arpruss/gamecube-usb-adapter/README.md

# gamecube-usb-adapter
stm32f103c-based gamecube USB HID adapter

For build instructions, see https://www.instructables.com/id/Gamecube-Controller-USB-Adapter-and-Getting-Starte/

Note: Nunchuck support is untested.
