arpruss/gamecube-usb-adapter/modelist.pdf

# Mappings with exercise machine support

0001: joystick (unified slider) 0010: joystick (2 sliders), 0.64x rot 0011: Jetset Radio joystick
0100: WASD
0101: Arrows + Ctrl/Space
0110: Arrows + Space/Back 0111: QBert (A=1, B=2) 1000: Dance pad Minecraft
1001: joystick, 1.5x rot 1010: joystick, 2x rot
1011: joystick, dir. switch slider 1100: Arrows + Z/X
1101: XBox 360
1110: Dual joystick

# Mappings without exercise machine support

### 0001: joystick (unified slider) 0010: joystick (two sliders) 0011: Jetset Radio joystick 0100: WASD 0101: Arrows + Ctrl/Space 0110: Arrows + Space/Back 0111: QBert (A=1, B=2) 1000: Dance pad Minecraft 1001: Arrows + Z/X 1010: XBox 360 1011: Dual joystick
