arpruss/gamecube-usb-adapter/gamecube-nunchuck-exercise.png

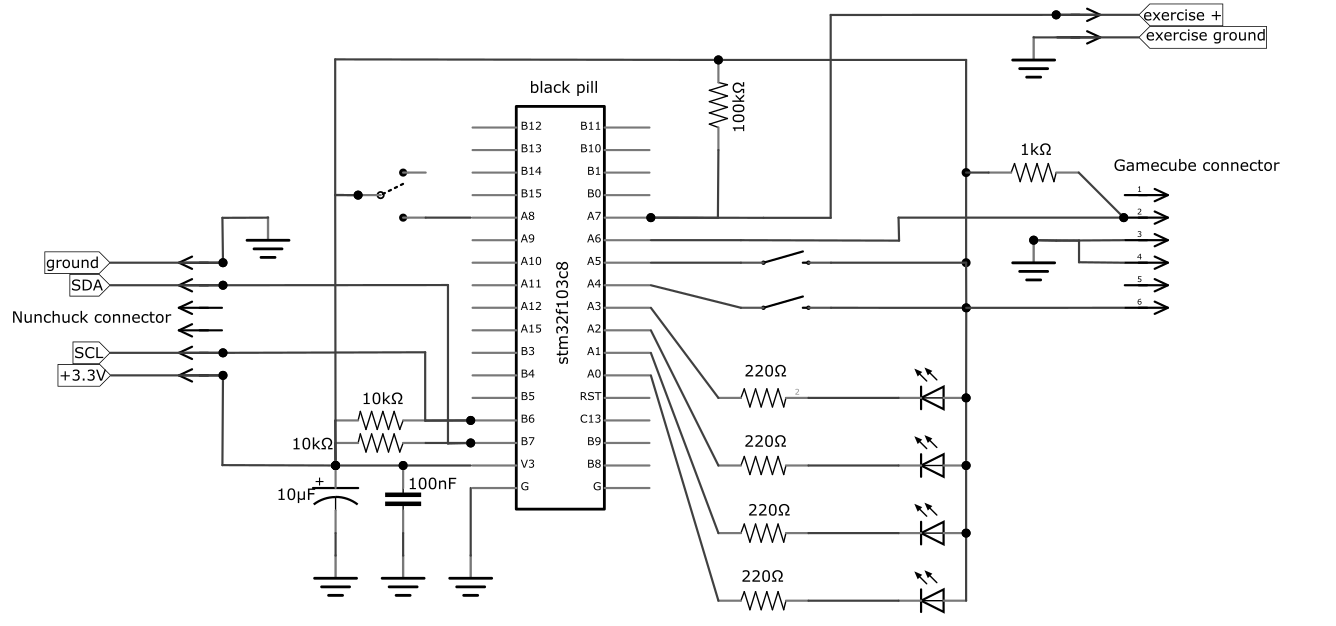
gamecube-nunchuck-exercise.png
