arpruss/gamecube-usb-adapter/gamecubecontroller_schem.png

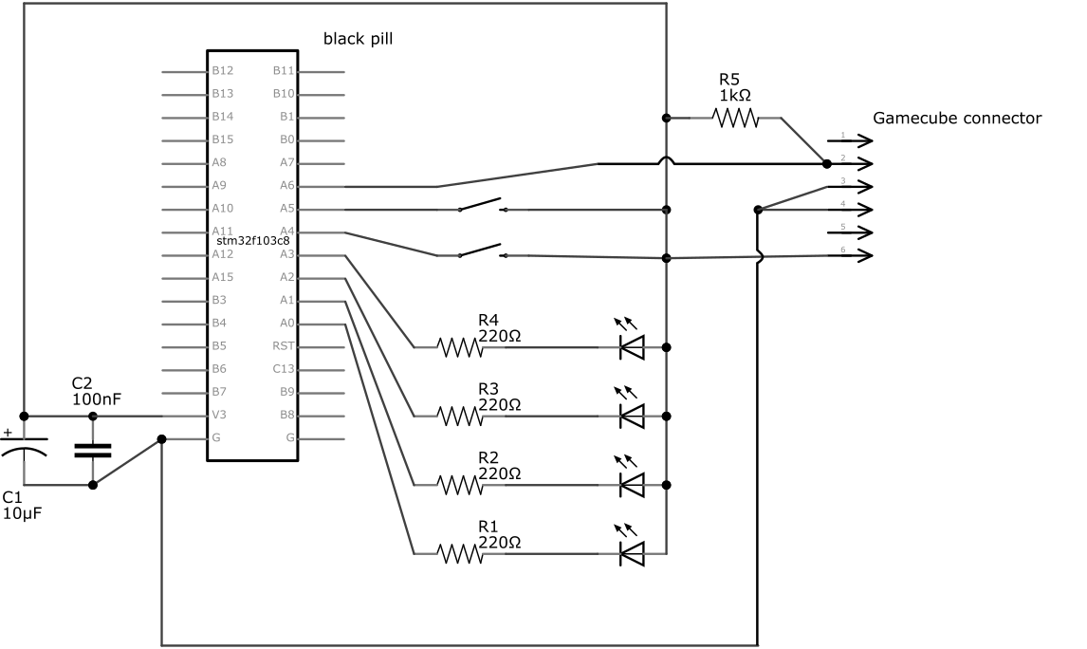
gamecubecontroller_schem.png
