arpruss/gamecube-usb-adapter/printable/gamecube-nunchuck-exercise-feet.stl

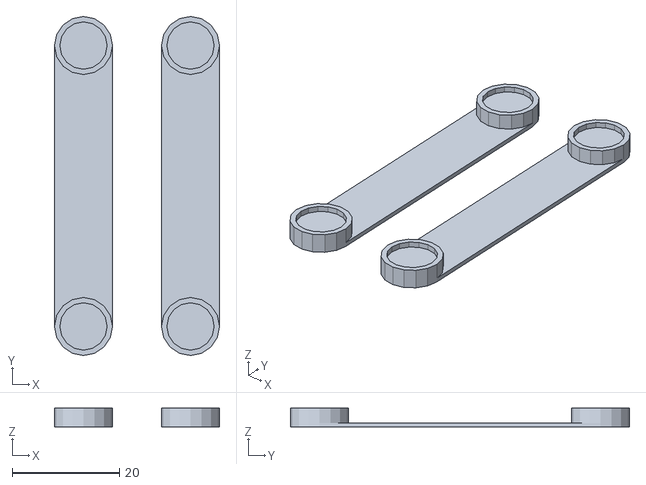
[picture p3: CAD file, 2018-01-15]
printable/gamecube-nunchuck-exercise-feet.stl
30.8 x 63.3 x 3.50
