arpruss/gamecube-usb-adapter/printable/adaptercase.stl

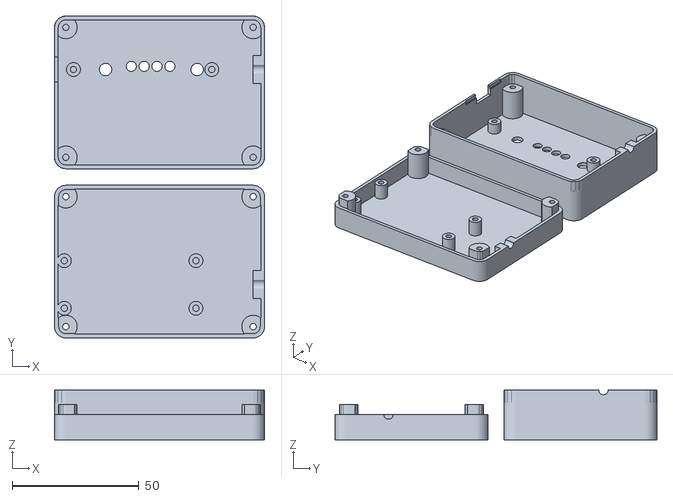
[picture p4: CAD file, 2018-01-14]
printable/adaptercase.stl
83.0 x 127.2 x 19.7
