arpruss/gamecube-usb-adapter/printable/gamecube-nunchuck-exercise-top.stl

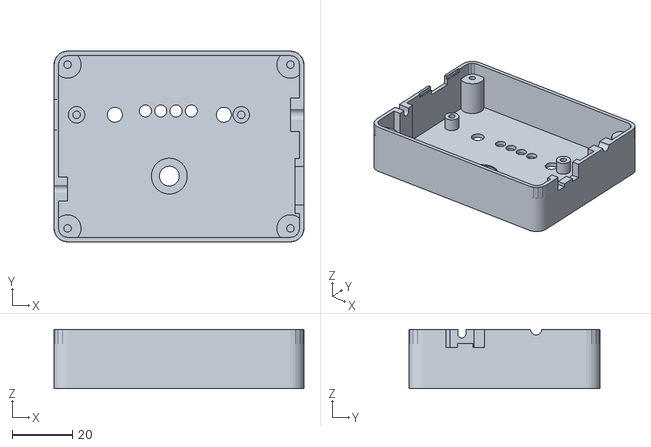
[picture p5: CAD file, 2018-01-14]
printable/gamecube-nunchuck-exercise-top.stl
83.0 x 63.3 x 19.7
