arpruss/gamecube-usb-adapter/printable/gamecube-nunchuck-exercise-bottom.stl

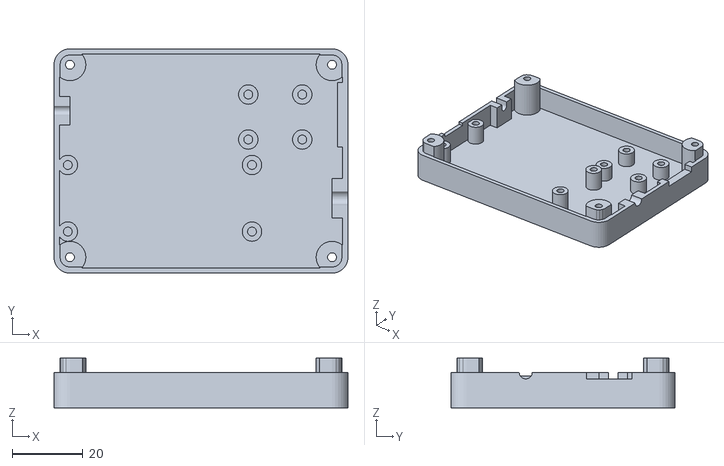
[picture p6: CAD file, 2018-01-14]
printable/gamecube-nunchuck-exercise-bottom.stl
83.0 x 63.4 x 14.0
