arpruss/gamecube-usb-adapter/(list of files, cad)

Other CAD files:
printable/roundedsquare.scad
