arpruss/gamecube-usb-adapter/(threads)

Thread 1 (2020-04-17):

XBOX 360 Controller issue

Croccy22, 2020-04-17:
Hi,

I have built this and it is all working in standard joystick mode, but whenI switch to XBOX 360 mode, it does it, the computer shows XBOX 360 controller, but then after a few seconds you here USB disconnect/reconnect and it resets back to normal joysitck mode.

Any ideas?

Thanks, MAtt.

arpruss, 2020-04-17:
What computer are you using?
And which version of the USB library are you using?

Croccy22, 2020-04-17:
I have tried it on my main PC and on my laptop, both with same result.
Computer can see it as XBOX 360 emulated device, but then resets back to
standard.

I am using the USBHID Library from here:
https://github.com/arpruss/USBComposite_stm32f1 I followed the guide from
here: Exercise Machine USB Game Controller : 8 Steps (with Pictures) -
Instructables
<https://www.instructables.com/id/Exercise-Machine-USB-Game-Controller/> but
the libraries didn't appear in the list as per the guide, so went direct to
github to download them.

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

arpruss, 2020-04-17:
Does the stm board reboot? You can tell by its doing the flashing lights startup sequence.
I've had this problem before...

arpruss, 2020-04-17:
Also, are you using the release versions or the current repository head?

Croccy22, 2020-04-17:
Yes I would definately say it is rebooting. I have been using the ones from the repository head. Shall I try the latest release libraires instead?

When I compiled I got the following messages:

In file included from C:\Users\matth\Documents\Arduino\libraries\USBComposite_stm32f1-master/usb_generic.h:11:0,

                 from C:\Users\matth\Documents\Arduino\libraries\USBComposite_stm32f1-master/USBComposite.h:6,

                 from sketch\gamecubecontroller.h:8,

                 from C:\Users\matth\Desktop\gamecubecontroller\gamecubecontroller.ino:51:

C:\Program Files (x86)\Arduino\hardware\Arduino_STM32\STM32F1\system/libmaple/usb/stm32f1/usb_reg_map.h: In function 'uint32* usb_pma_ptr(uint32)':

C:\Program Files (x86)\Arduino\hardware\Arduino_STM32\STM32F1\system/libmaple/usb/stm32f1/usb_reg_map.h:353:35: warning: pointer of type 'void *' used in arithmetic [-Wpointer-arith]

     return (uint32*)(USB_PMA_BASE + 2 * offset);

                                   ^

In file included from C:\Users\matth\Documents\Arduino\libraries\USBComposite_stm32f1-master\usb_generic.h:11:0,

                 from C:\Users\matth\Documents\Arduino\libraries\USBComposite_stm32f1-master\USBComposite.h:6,

                 from C:\Users\matth\Documents\Arduino\libraries\USBComposite_stm32f1-master\AbsMouse.cpp:1:

C:\Program Files (x86)\Arduino\hardware\Arduino_STM32\STM32F1\system/libmaple/usb/stm32f1/usb_reg_map.h: In function 'uint32* usb_pma_ptr(uint32)':

C:\Program Files (x86)\Arduino\hardware\Arduino_STM32\STM32F1\system/libmaple/usb/stm32f1/usb_reg_map.h:353:35: warning: pointer of type 'void *' used in arithmetic [-Wpointer-arith]

     return (uint32*)(USB_PMA_BASE + 2 * offset);

                                   ^

In file included from C:\Users\matth\Documents\Arduino\libraries\USBComposite_stm32f1-master\usb_generic.h:11:0,

                 from C:\Users\matth\Documents\Arduino\libraries\USBComposite_stm32f1-master\USBComposite.h:6,

                 from C:\Users\matth\Documents\Arduino\libraries\USBComposite_stm32f1-master\Consumer.cpp:1:

C:\Program Files (x86)\Arduino\hardware\Arduino_STM32\STM32F1\system/libmaple/usb/stm32f1/usb_reg_map.h: In function 'uint32* usb_pma_ptr(uint32)':

C:\Program Files (x86)\Arduino\hardware\Arduino_STM32\STM32F1\system/libmaple/usb/stm32f1/usb_reg_map.h:353:35: warning: pointer of type 'void *' used in arithmetic [-Wpointer-arith]

     return (uint32*)(USB_PMA_BASE + 2 * offset);

                                   ^

In file included from C:\Users\matth\Documents\Arduino\libraries\USBComposite_stm32f1-master\usb_generic.h:11:0,

                 from C:\Users\matth\Documents\Arduino\libraries\USBComposite_stm32f1-master\USBComposite.h:6,

                 from C:\Users\matth\Documents\Arduino\libraries\USBComposite_stm32f1-master\HIDReports.cpp:1:

C:\Program Files (x86)\Arduino\hardware\Arduino_STM32\STM32F1\system/libmaple/usb/stm32f1/usb_reg_map.h: In function 'uint32* usb_pma_ptr(uint32)':

C:\Program Files (x86)\Arduino\hardware\Arduino_STM32\STM32F1\system/libmaple/usb/stm32f1/usb_reg_map.h:353:35: warning: pointer of type 'void *' used in arithmetic [-Wpointer-arith]

     return (uint32*)(USB_PMA_BASE + 2 * offset);

                                   ^

In file included from C:\Users\matth\Documents\Arduino\libraries\USBComposite_stm32f1-master\usb_generic.h:11:0,

                 from C:\Users\matth\Documents\Arduino\libraries\USBComposite_stm32f1-master\USBComposite.h:6,

                 from C:\Users\matth\Documents\Arduino\libraries\USBComposite_stm32f1-master\Joystick.cpp:1:

C:\Program Files (x86)\Arduino\hardware\Arduino_STM32\STM32F1\system/libmaple/usb/stm32f1/usb_reg_map.h: In function 'uint32* usb_pma_ptr(uint32)':

C:\Program Files (x86)\Arduino\hardware\Arduino_STM32\STM32F1\system/libmaple/usb/stm32f1/usb_reg_map.h:353:35: warning: pointer of type 'void *' used in arithmetic [-Wpointer-arith]

     return (uint32*)(USB_PMA_BASE + 2 * offset);

                                   ^

In file included from C:\Users\matth\Documents\Arduino\libraries\USBComposite_stm32f1-master\usb_generic.h:11:0,

                 from C:\Users\matth\Documents\Arduino\libraries\USBComposite_stm32f1-master\USBComposite.h:6,

                 from C:\Users\matth\Documents\Arduino\libraries\USBComposite_stm32f1-master\Keyboard.cpp:1:

C:\Program Files (x86)\Arduino\hardware\Arduino_STM32\STM32F1\system/libmaple/usb/stm32f1/usb_reg_map.h: In function 'uint32* usb_pma_ptr(uint32)':

C:\Program Files (x86)\Arduino\hardware\Arduino_STM32\STM32F1\system/libmaple/usb/stm32f1/usb_reg_map.h:353:35: warning: pointer of type 'void *' used in arithmetic [-Wpointer-arith]

     return (uint32*)(USB_PMA_BASE + 2 * offset);

                                   ^

In file included from C:\Users\matth\Documents\Arduino\libraries\USBComposite_stm32f1-master\usb_generic.h:11:0,

                 from C:\Users\matth\Documents\Arduino\libraries\USBComposite_stm32f1-master\USBComposite.h:6,

                 from C:\Users\matth\Documents\Arduino\libraries\USBComposite_stm32f1-master\Mouse.cpp:1:

C:\Program Files (x86)\Arduino\hardware\Arduino_STM32\STM32F1\system/libmaple/usb/stm32f1/usb_reg_map.h: In function 'uint32* usb_pma_ptr(uint32)':

C:\Program Files (x86)\Arduino\hardware\Arduino_STM32\STM32F1\system/libmaple/usb/stm32f1/usb_reg_map.h:353:35: warning: pointer of type 'void *' used in arithmetic [-Wpointer-arith]

     return (uint32*)(USB_PMA_BASE + 2 * offset);

                                   ^

In file included from C:\Users\matth\Documents\Arduino\libraries\USBComposite_stm32f1-master\usb_generic.h:11:0,

                 from C:\Users\matth\Documents\Arduino\libraries\USBComposite_stm32f1-master\USBComposite.h:6,

                 from C:\Users\matth\Documents\Arduino\libraries\USBComposite_stm32f1-master\USBAudio.cpp:17:

C:\Program Files (x86)\Arduino\hardware\Arduino_STM32\STM32F1\system/libmaple/usb/stm32f1/usb_reg_map.h: In function 'uint32* usb_pma_ptr(uint32)':

C:\Program Files (x86)\Arduino\hardware\Arduino_STM32\STM32F1\system/libmaple/usb/stm32f1/usb_reg_map.h:353:35: warning: pointer of type 'void *' used in arithmetic [-Wpointer-arith]

     return (uint32*)(USB_PMA_BASE + 2 * offset);

                                   ^

In file included from C:\Users\matth\Documents\Arduino\libraries\USBComposite_stm32f1-master\usb_generic.h:11:0,

                 from C:\Users\matth\Documents\Arduino\libraries\USBComposite_stm32f1-master\USBComposite.h:6,

                 from C:\Users\matth\Documents\Arduino\libraries\USBComposite_stm32f1-master\USBComposite.cpp:1:

C:\Program Files (x86)\Arduino\hardware\Arduino_STM32\STM32F1\system/libmaple/usb/stm32f1/usb_reg_map.h: In function 'uint32* usb_pma_ptr(uint32)':

C:\Program Files (x86)\Arduino\hardware\Arduino_STM32\STM32F1\system/libmaple/usb/stm32f1/usb_reg_map.h:353:35: warning: pointer of type 'void *' used in arithmetic [-Wpointer-arith]

     return (uint32*)(USB_PMA_BASE + 2 * offset);

                                   ^

In file included from C:\Users\matth\Documents\Arduino\libraries\USBComposite_stm32f1-master\usb_generic.h:11:0,

                 from C:\Users\matth\Documents\Arduino\libraries\USBComposite_stm32f1-master\USBComposite.h:6,

                 from C:\Users\matth\Documents\Arduino\libraries\USBComposite_stm32f1-master\USBCompositeSerial.cpp:17:

C:\Program Files (x86)\Arduino\hardware\Arduino_STM32\STM32F1\system/libmaple/usb/stm32f1/usb_reg_map.h: In function 'uint32* usb_pma_ptr(uint32)':

C:\Program Files (x86)\Arduino\hardware\Arduino_STM32\STM32F1\system/libmaple/usb/stm32f1/usb_reg_map.h:353:35: warning: pointer of type 'void *' used in arithmetic [-Wpointer-arith]

     return (uint32*)(USB_PMA_BASE + 2 * offset);

                                   ^

In file included from C:\Users\matth\Documents\Arduino\libraries\USBComposite_stm32f1-master\usb_generic.h:11:0,

                 from C:\Users\matth\Documents\Arduino\libraries\USBComposite_stm32f1-master\USBComposite.h:6,

                 from C:\Users\matth\Documents\Arduino\libraries\USBComposite_stm32f1-master\USBHID.cpp:18:

C:\Program Files (x86)\Arduino\hardware\Arduino_STM32\STM32F1\system/libmaple/usb/stm32f1/usb_reg_map.h: In function 'uint32* usb_pma_ptr(uint32)':

C:\Program Files (x86)\Arduino\hardware\Arduino_STM32\STM32F1\system/libmaple/usb/stm32f1/usb_reg_map.h:353:35: warning: pointer of type 'void *' used in arithmetic [-Wpointer-arith]

     return (uint32*)(USB_PMA_BASE + 2 * offset);

                                   ^

In file included from C:\Users\matth\Documents\Arduino\libraries\USBComposite_stm32f1-master\usb_generic.h:11:0,

                 from C:\Users\matth\Documents\Arduino\libraries\USBComposite_stm32f1-master\USBComposite.h:6,

                 from C:\Users\matth\Documents\Arduino\libraries\USBComposite_stm32f1-master\USBMIDI.cpp:41:

C:\Program Files (x86)\Arduino\hardware\Arduino_STM32\STM32F1\system/libmaple/usb/stm32f1/usb_reg_map.h: In function 'uint32* usb_pma_ptr(uint32)':

C:\Program Files (x86)\Arduino\hardware\Arduino_STM32\STM32F1\system/libmaple/usb/stm32f1/usb_reg_map.h:353:35: warning: pointer of type 'void *' used in arithmetic [-Wpointer-arith]

     return (uint32*)(USB_PMA_BASE + 2 * offset);

                                   ^

In file included from C:\Users\matth\Documents\Arduino\libraries\USBComposite_stm32f1-master\usb_generic.h:11:0,

                 from C:\Users\matth\Documents\Arduino\libraries\USBComposite_stm32f1-master\USBComposite.h:6,

                 from C:\Users\matth\Documents\Arduino\libraries\USBComposite_stm32f1-master\USBMassStorage.cpp:1:

C:\Program Files (x86)\Arduino\hardware\Arduino_STM32\STM32F1\system/libmaple/usb/stm32f1/usb_reg_map.h: In function 'uint32* usb_pma_ptr(uint32)':

C:\Program Files (x86)\Arduino\hardware\Arduino_STM32\STM32F1\system/libmaple/usb/stm32f1/usb_reg_map.h:353:35: warning: pointer of type 'void *' used in arithmetic [-Wpointer-arith]

     return (uint32*)(USB_PMA_BASE + 2 * offset);

                                   ^

In file included from C:\Users\matth\Documents\Arduino\libraries\USBComposite_stm32f1-master\usb_generic.h:11:0,

                 from C:\Users\matth\Documents\Arduino\libraries\USBComposite_stm32f1-master\USBComposite.h:6,

                 from C:\Users\matth\Documents\Arduino\libraries\USBComposite_stm32f1-master\USBMultiSerial.cpp:17:

C:\Program Files (x86)\Arduino\hardware\Arduino_STM32\STM32F1\system/libmaple/usb/stm32f1/usb_reg_map.h: In function 'uint32* usb_pma_ptr(uint32)':

C:\Program Files (x86)\Arduino\hardware\Arduino_STM32\STM32F1\system/libmaple/usb/stm32f1/usb_reg_map.h:353:35: warning: pointer of type 'void *' used in arithmetic [-Wpointer-arith]

     return (uint32*)(USB_PMA_BASE + 2 * offset);

                                   ^

In file included from C:\Users\matth\Documents\Arduino\libraries\USBComposite_stm32f1-master\usb_generic.h:11:0,

                 from C:\Users\matth\Documents\Arduino\libraries\USBComposite_stm32f1-master\USBComposite.h:6,

                 from C:\Users\matth\Documents\Arduino\libraries\USBComposite_stm32f1-master\USBMultiXBox360.cpp:18:

C:\Program Files (x86)\Arduino\hardware\Arduino_STM32\STM32F1\system/libmaple/usb/stm32f1/usb_reg_map.h: In function 'uint32* usb_pma_ptr(uint32)':

C:\Program Files (x86)\Arduino\hardware\Arduino_STM32\STM32F1\system/libmaple/usb/stm32f1/usb_reg_map.h:353:35: warning: pointer of type 'void *' used in arithmetic [-Wpointer-arith]

     return (uint32*)(USB_PMA_BASE + 2 * offset);

                                   ^

In file included from C:\Users\matth\Documents\Arduino\libraries\USBComposite_stm32f1-master\usb_generic.h:11:0,

                 from C:\Users\matth\Documents\Arduino\libraries\USBComposite_stm32f1-master\USBComposite.h:6,

                 from C:\Users\matth\Documents\Arduino\libraries\USBComposite_stm32f1-master\USBXBox360Reporter.cpp:18:

C:\Program Files (x86)\Arduino\hardware\Arduino_STM32\STM32F1\system/libmaple/usb/stm32f1/usb_reg_map.h: In function 'uint32* usb_pma_ptr(uint32)':

C:\Program Files (x86)\Arduino\hardware\Arduino_STM32\STM32F1\system/libmaple/usb/stm32f1/usb_reg_map.h:353:35: warning: pointer of type 'void *' used in arithmetic [-Wpointer-arith]

     return (uint32*)(USB_PMA_BASE + 2 * offset);

                                   ^

In file included from C:\Users\matth\Documents\Arduino\libraries\USBComposite_stm32f1-master\usb_generic.h:11:0,

                 from C:\Users\matth\Documents\Arduino\libraries\USBComposite_stm32f1-master\USBComposite.h:6,

                 from C:\Users\matth\Documents\Arduino\libraries\USBComposite_stm32f1-master\USBXBox360W.cpp:18:

C:\Program Files (x86)\Arduino\hardware\Arduino_STM32\STM32F1\system/libmaple/usb/stm32f1/usb_reg_map.h: In function 'uint32* usb_pma_ptr(uint32)':

C:\Program Files (x86)\Arduino\hardware\Arduino_STM32\STM32F1\system/libmaple/usb/stm32f1/usb_reg_map.h:353:35: warning: pointer of type 'void *' used in arithmetic [-Wpointer-arith]

     return (uint32*)(USB_PMA_BASE + 2 * offset);

                                   ^

Sketch uses 41048 bytes (62%) of program storage space. Maximum is 65536 bytes.
Global variables use 7488 bytes (36%) of dynamic memory, leaving 12992 bytes for local variables. Maximum is 20480 bytes.

arpruss, 2020-04-17:
Two things to try.
1. In the main ino file, comment out the line: iwdg_init(IWDG_PRE_256, watchdogSeconds*156);
See what happens. If that doesn't work, then:
 2. Comment out the two inject() calls in the loop() function and see what happens.

Croccy22, 2020-04-17:
Commenting out the line: iwdg_init(IWDG_PRE_256, watchdogSeconds*156);
Seems to have done the job :)

Will hook it all back up and give it a test.

Thanks :)

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

arpruss, 2020-04-17:
I'll be a little surprised if it actually works as a controller without that line. What the watchdog does is it reboots the board if it hangs for ten seconds.

Croccy22, 2020-04-17:
Yes you are correct, so the device stays connected now but in 360
controller mode it still doesn't work. Only works in standard joystick mode.

I have tried using the latest release libraries instead and still gt
the same issue. Also tried some older ones with same result. Tried older
still but it woulnd't compile anymore saying about the xbox 360 controller
so i guess that wasn't implemented in those libraries at the time.

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

arpruss, 2020-04-17:
Try this: switch to 360 mode. Wait 20 seconds. Unplug and plug back in. It should start up in 360 mode, and has a good chance of working. But now it probably won't work if you switch to a different mode from 360 mode.

Is your USB resistor on the board correct?

What operating system are you using?

Croccy22, 2020-04-17:
I did manage to get it to boot up in xbox 360 mode and it worked fine, I
could then switch to other modes and they worked too. However I then
powered it off again and now for some reason I can't get it to "save" xbox
360 mode again, will keep trying

Only thing I can think of is that in your guide you use a black pill board.
Mine is a blue pill board. I'm not sure if there are any hardware
differences between them? I can order a black pill and try it, I just
happened to have this one laying around and they seemed the same from what
I could see.

Which resistor do you mean?

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

arpruss, 2020-04-17:
1. The blue pills have a wrong USB resistor, typically 10K instead of 1.5K. With some computers, they'll work fine, but they may give trouble with others. Check your resistance between 3.3V and A12. If it's not 1.5K, add a resistor in parallel between these pins to get 1.5K. For instance, if you have 10K, then add a 1.8K resistor.

2. My guess is that the computer (what is its operating system) is not registering the switch from one USB device to another. (The XBox is different from the other USB modes: it needs to change device numbers and HID profiles.) While there is a workaround (see point 4), I would prefer to figure out the problem with the switch. Here is what I would like you to try. In setup(), add the line:
```
USBComposite.setDisconnectDelay(500);
```
And then experiment with changing the delay value in microseconds. First thing to try is a really high value, like 2500. Second thing, is a low value, like 200. The value of 500 is a compromise between the RPI 3B+ which needs a high value and some Macs and other computers that need a low value.

4. The mode setting saves to flash if you leave the device in a given mode for 15 seconds. If you change that to 5 seconds (the setting is in gamecubecontroller.h), then you may be able to switch between XBox and other modes by switching modes, and then waiting for the reboot.

arpruss, 2020-04-17:
BTW, the pointer arithmetic error you saw in the log should now be fixed with the latest commit to the libmaple core. But that shouldn't affect this issue.

Croccy22, 2020-04-17:
Sorry, I forgot to say I am running Windows 10 latest version on all computers.

Will check the resistance and add a resistor and let you know. Will test out the delay setting too.

For now I set the saveInjectionModeAfterMillis value to 1ms so it instantly saves the mode change. I can now switch the xbox360 mode, power off and power back on to get it to stay in this mode.

Thanks for all your help :)

Croccy22, 2020-04-17:
I have tried the delay with values 200,500 and 2500. None made any difference, but this is without doing anything with the resistor yet. Will try that later and then give the values another go.

arpruss, 2020-04-17:
Don't set it to 1 ms. That means that each time you press a mode change button, you will save, which introduces wear-and-tear on the flash. Set it to at least 1000.

arpruss, 2020-04-17:
I just tried building and using this on my Win10 laptop. Works fine with the latest USB Composite, gamecube usb adapter sketch and Roger's libmaple core (but I had to delete the copy of USBComposite that came with the core). Here's my build log:
```
C:\Program Files (x86)\Arduino\arduino-builder -dump-prefs -logger=machine -hardware C:\Program Files (x86)\Arduino\hardware -hardware C:\Users\[username]\AppData\Local\Arduino15\packages -hardware C:\Users\[username]\Arduino\hardware -tools C:\Program Files (x86)\Arduino\tools-builder -tools C:\Program Files (x86)\Arduino\hardware\tools\avr -tools C:\Users\[username]\AppData\Local\Arduino15\packages -built-in-libraries C:\Program Files (x86)\Arduino\libraries -libraries C:\Users\[username]\Arduino\libraries -fqbn=roger-core:STM32F1:genericSTM32F103C:device_variant=STM32F103CB,upload_method=DFUUploadMethod,cpu_speed=speed_72mhz,opt=osstd -ide-version=10802 -build-path C:\Users\ALEXAN~1\AppData\Local\Temp\arduino_build_255114 -warnings=all -build-cache C:\Users\ALEXAN~1\AppData\Local\Temp\arduino_cache_197311 -prefs=build.warn_data_percentage=75 -verbose C:\Users\[username]\Arduino\gamecubecontroller\gamecubecontroller.ino
C:\Program Files (x86)\Arduino\arduino-builder -compile -logger=machine -hardware C:\Program Files (x86)\Arduino\hardware -hardware C:\Users\[username]\AppData\Local\Arduino15\packages -hardware C:\Users\[username]\Arduino\hardware -tools C:\Program Files (x86)\Arduino\tools-builder -tools C:\Program Files (x86)\Arduino\hardware\tools\avr -tools C:\Users\[username]\AppData\Local\Arduino15\packages -built-in-libraries C:\Program Files (x86)\Arduino\libraries -libraries C:\Users\[username]\Arduino\libraries -fqbn=roger-core:STM32F1:genericSTM32F103C:device_variant=STM32F103CB,upload_method=DFUUploadMethod,cpu_speed=speed_72mhz,opt=osstd -ide-version=10802 -build-path C:\Users\ALEXAN~1\AppData\Local\Temp\arduino_build_255114 -warnings=all -build-cache C:\Users\ALEXAN~1\AppData\Local\Temp\arduino_cache_197311 -prefs=build.warn_data_percentage=75 -verbose C:\Users\[username]\Arduino\gamecubecontroller\gamecubecontroller.ino
Using board 'genericSTM32F103C' from platform in folder: C:\Users\[username]\Arduino\hardware\roger-core\STM32F1
Using core 'maple' from platform in folder: C:\Users\[username]\Arduino\hardware\roger-core\STM32F1
Detecting libraries used...
"C:\Users\[username]\AppData\Local\Arduino15\packages\arduino\tools\arm-none-eabi-gcc\4.8.3-2014q1/bin/arm-none-eabi-g++" -c -g -Os -w -DDEBUG_LEVEL=DEBUG_NONE -std=gnu++11  -ffunction-sections -fdata-sections -nostdlib --param max-inline-insns-single=500 -fno-rtti -fno-exceptions -fno-use-cxa-atexit -DBOARD_generic_stm32f103c -DVECT_TAB_ADDR=0x8002000 -DERROR_LED_PORT=GPIOC -DERROR_LED_PIN=13 -w -x c++ -E -CC -mcpu=cortex-m3 -DF_CPU=72000000L -DARDUINO=10802 -DARDUINO_GENERIC_STM32F103C -DARDUINO_ARCH_STM32F1  -DSERIAL_USB -DGENERIC_BOOTLOADER -DMCU_STM32F103CB  -mthumb  -march=armv7-m -D__STM32F1__ -DMCU_STM32F103CB  -mthumb  -march=armv7-m -D__STM32F1__ "-IC:\Users\[username]\Arduino\hardware\roger-core\STM32F1\system/libmaple" "-IC:\Users\[username]\Arduino\hardware\roger-core\STM32F1\system/libmaple/include" "-IC:\Users\[username]\Arduino\hardware\roger-core\STM32F1\system/libmaple/stm32f1/include" "-IC:\Users\[username]\Arduino\hardware\roger-core\STM32F1\system/libmaple/usb/stm32f1" "-IC:\Users\[username]\Arduino\hardware\roger-core\STM32F1\system/libmaple/usb/usb_lib" "-IC:\Users\[username]\Arduino\hardware\roger-core\STM32F1\cores\maple" "-IC:\Users\[username]\Arduino\hardware\roger-core\STM32F1\variants\generic_stm32f103c" "C:\Users\ALEXAN~1\AppData\Local\Temp\arduino_build_255114\sketch\gamecubecontroller.ino.cpp" -o "nul"
"C:\Users\[username]\AppData\Local\Arduino15\packages\arduino\tools\arm-none-eabi-gcc\4.8.3-2014q1/bin/arm-none-eabi-g++" -c -g -Os -w -DDEBUG_LEVEL=DEBUG_NONE -std=gnu++11  -ffunction-sections -fdata-sections -nostdlib --param max-inline-insns-single=500 -fno-rtti -fno-exceptions -fno-use-cxa-atexit -DBOARD_generic_stm32f103c -DVECT_TAB_ADDR=0x8002000 -DERROR_LED_PORT=GPIOC -DERROR_LED_PIN=13 -w -x c++ -E -CC -mcpu=cortex-m3 -DF_CPU=72000000L -DARDUINO=10802 -DARDUINO_GENERIC_STM32F103C -DARDUINO_ARCH_STM32F1  -DSERIAL_USB -DGENERIC_BOOTLOADER -DMCU_STM32F103CB  -mthumb  -march=armv7-m -D__STM32F1__ -DMCU_STM32F103CB  -mthumb  -march=armv7-m -D__STM32F1__ "-IC:\Users\[username]\Arduino\hardware\roger-core\STM32F1\system/libmaple" "-IC:\Users\[username]\Arduino\hardware\roger-core\STM32F1\system/libmaple/include" "-IC:\Users\[username]\Arduino\hardware\roger-core\STM32F1\system/libmaple/stm32f1/include" "-IC:\Users\[username]\Arduino\hardware\roger-core\STM32F1\system/libmaple/usb/stm32f1" "-IC:\Users\[username]\Arduino\hardware\roger-core\STM32F1\system/libmaple/usb/usb_lib" "-IC:\Users\[username]\Arduino\hardware\roger-core\STM32F1\cores\maple" "-IC:\Users\[username]\Arduino\hardware\roger-core\STM32F1\variants\generic_stm32f103c" "-IC:\Users\[username]\Arduino\libraries\GameControllersSTM32\src" "C:\Users\ALEXAN~1\AppData\Local\Temp\arduino_build_255114\sketch\gamecubecontroller.ino.cpp" -o "nul"
"C:\Users\[username]\AppData\Local\Arduino15\packages\arduino\tools\arm-none-eabi-gcc\4.8.3-2014q1/bin/arm-none-eabi-g++" -c -g -Os -w -DDEBUG_LEVEL=DEBUG_NONE -std=gnu++11  -ffunction-sections -fdata-sections -nostdlib --param max-inline-insns-single=500 -fno-rtti -fno-exceptions -fno-use-cxa-atexit -DBOARD_generic_stm32f103c -DVECT_TAB_ADDR=0x8002000 -DERROR_LED_PORT=GPIOC -DERROR_LED_PIN=13 -w -x c++ -E -CC -mcpu=cortex-m3 -DF_CPU=72000000L -DARDUINO=10802 -DARDUINO_GENERIC_STM32F103C -DARDUINO_ARCH_STM32F1  -DSERIAL_USB -DGENERIC_BOOTLOADER -DMCU_STM32F103CB  -mthumb  -march=armv7-m -D__STM32F1__ -DMCU_STM32F103CB  -mthumb  -march=armv7-m -D__STM32F1__ "-IC:\Users\[username]\Arduino\hardware\roger-core\STM32F1\system/libmaple" "-IC:\Users\[username]\Arduino\hardware\roger-core\STM32F1\system/libmaple/include" "-IC:\Users\[username]\Arduino\hardware\roger-core\STM32F1\system/libmaple/stm32f1/include" "-IC:\Users\[username]\Arduino\hardware\roger-core\STM32F1\system/libmaple/usb/stm32f1" "-IC:\Users\[username]\Arduino\hardware\roger-core\STM32F1\system/libmaple/usb/usb_lib" "-IC:\Users\[username]\Arduino\hardware\roger-core\STM32F1\cores\maple" "-IC:\Users\[username]\Arduino\hardware\roger-core\STM32F1\variants\generic_stm32f103c" "-IC:\Users\[username]\Arduino\libraries\GameControllersSTM32\src" "-IC:\Users\[username]\Arduino\hardware\roger-core\STM32F1\libraries\Wire" "C:\Users\ALEXAN~1\AppData\Local\Temp\arduino_build_255114\sketch\gamecubecontroller.ino.cpp" -o "nul"
"C:\Users\[username]\AppData\Local\Arduino15\packages\arduino\tools\arm-none-eabi-gcc\4.8.3-2014q1/bin/arm-none-eabi-g++" -c -g -Os -w -DDEBUG_LEVEL=DEBUG_NONE -std=gnu++11  -ffunction-sections -fdata-sections -nostdlib --param max-inline-insns-single=500 -fno-rtti -fno-exceptions -fno-use-cxa-atexit -DBOARD_generic_stm32f103c -DVECT_TAB_ADDR=0x8002000 -DERROR_LED_PORT=GPIOC -DERROR_LED_PIN=13 -w -x c++ -E -CC -mcpu=cortex-m3 -DF_CPU=72000000L -DARDUINO=10802 -DARDUINO_GENERIC_STM32F103C -DARDUINO_ARCH_STM32F1  -DSERIAL_USB -DGENERIC_BOOTLOADER -DMCU_STM32F103CB  -mthumb  -march=armv7-m -D__STM32F1__ -DMCU_STM32F103CB  -mthumb  -march=armv7-m -D__STM32F1__ "-IC:\Users\[username]\Arduino\hardware\roger-core\STM32F1\system/libmaple" "-IC:\Users\[username]\Arduino\hardware\roger-core\STM32F1\system/libmaple/include" "-IC:\Users\[username]\Arduino\hardware\roger-core\STM32F1\system/libmaple/stm32f1/include" "-IC:\Users\[username]\Arduino\hardware\roger-core\STM32F1\system/libmaple/usb/stm32f1" "-IC:\Users\[username]\Arduino\hardware\roger-core\STM32F1\system/libmaple/usb/usb_lib" "-IC:\Users\[username]\Arduino\hardware\roger-core\STM32F1\cores\maple" "-IC:\Users\[username]\Arduino\hardware\roger-core\STM32F1\variants\generic_stm32f103c" "-IC:\Users\[username]\Arduino\libraries\GameControllersSTM32\src" "-IC:\Users\[username]\Arduino\hardware\roger-core\STM32F1\libraries\Wire" "-IC:\Users\[username]\Arduino\libraries\usbhid-master" "C:\Users\ALEXAN~1\AppData\Local\Temp\arduino_build_255114\sketch\gamecubecontroller.ino.cpp" -o "nul"
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
