arpruss/gamecube-usb-adapter/(list of files, drawings)

Other design files:
gamecube-nunchuck-exercise.fzz
gamecubecontroller.fzz
