arpruss/gamecube-usb-adapter/gamecubecontroller.ino

// This requires these libraries: 
//    https://github.com/arpruss/USBHID_stm32f1
//    https://github.com/arpruss/GameControllersSTM32
// Software steps:
//    Install this bootloader: https://github.com/rogerclarkmelbourne/STM32duino-bootloader/blob/master/binaries/generic_boot20_pb12.bin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
//    Instructions here: http://wiki.stm32duino.com/index.php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  
//    Install official Arduino Zero board
//    Put the contents of the above branch in your Arduino/Hardware folder
//    If on Windows, run drivers\win\install_drivers.bat
//    Install the USBHID_stm32f1 and GameControllersSTM32 libraries.
// Note: You may need to adjust permissions on some of the dll, exe and bat files.

// Facing GameCube socket (as on console), flat on top:
//    123
//    ===
//    456

// Connections for GameCube adapter:
// GameCube 2--PA6
// GameCube 2--1Kohm--3.3V
// GameCube 3--GND
// GameCube 4--GND
// GameCube 6--3.3V
// Put a 10 uF and 0.1 uF capacitor between 3.3V and GND right on the black pill board.
// optional: connect GameCube 1--5V (rumble, make sure there is enough current; you can also try 3.3V if you want)

// Put LEDs + resistors (100-220 ohm) between PA0,PA1,PA2,PA3 and 3.3V 

// Connections for exerciseMachine/bike:
// GND--GND
// PA7--4.7Kohm--rotation detector [the resistor may not be needed]
// PA7--100Kohm--3.3V

// For direction switch, to tell the device if you're pedaling backwards or forwards
// PA8 - direction control switch, one side
// 3.3V - direction control switch, other side

// Connections for Nunchuck
// GND--GND
// 3.3V--3.3V
// PB6--10Kohm--3.3V
// PB7--10Kohm--3.3V
// PB6--SCL
// PB7--SDA

#include <GameControllers.h>
#include <stdlib.h>
#include <libmaple/iwdg.h>
#include "debounce.h"
#include "gamecubecontroller.h"

NunchuckController nunchuck;
GameCubeController gc(gcPinID);
Debounce debounceDown(downButton, HIGH);
Debounce debounceUp(upButton, HIGH);
unsigned numDisplayableModes = 0;
uint8 leftMotor = 0;
uint8 rightMotor = 0; 
uint32 lastRumbleOff = 0;

void displayNumber(uint8_t x) {
  for (int i=0; i<numIndicators; i++, x>>=1) 
    analogWrite(indicatorLEDs[i], (x&1) ? (255-ledBrightnessLevels[i]) : 255);
    //digitalWrite(indicatorLEDs[i], !(x&1));
}

void updateDisplay() {
  if (injectors[injectionMode].show) {
    unsigned count = 0;
    for (unsigned i = 0 ; i < injectionMode ; i++) {
      if (injectors[i].show)
        count++;
    }
    displayNumber(numDisplayableModes >= 16 ? count : count+1);    
  }
  else {
    displayNumber(0);
  }
}

const uint8_t reportDescription[] = {
   HID_MOUSE_REPORT_DESCRIPTOR(),
   HID_KEYBOARD_REPORT_DESCRIPTOR(),
   HID_JOYSTICK_REPORT_DESCRIPTOR(HID_JOYSTICK_REPORT_ID, 
        HID_FEATURE_REPORT_DESCRIPTOR(FEATURE_DATA_SIZE))
        ,
};

const uint8_t dualJoystickReportDescription[] = {
   HID_MOUSE_REPORT_DESCRIPTOR(),
   HID_KEYBOARD_REPORT_DESCRIPTOR(),
   HID_JOYSTICK_REPORT_DESCRIPTOR(HID_JOYSTICK_REPORT_ID, 
        HID_FEATURE_REPORT_DESCRIPTOR(FEATURE_DATA_SIZE)),
   HID_JOYSTICK_REPORT_DESCRIPTOR(HID_JOYSTICK_REPORT_ID+1)
};

const uint8_t switchReportDescription[] = {
  HID_SWITCH_CONTROLLER_REPORT_DESCRIPTOR(
    HID_FEATURE_REPORT_DESCRIPTOR(FEATURE_DATA_SIZE)
    )
};

uint8_t featureReport[FEATURE_DATA_SIZE];
uint8_t featureBuffer[HID_BUFFER_ALLOCATE_SIZE(FEATURE_DATA_SIZE,1)];
volatile HIDBuffer_t fb { featureBuffer, HID_BUFFER_SIZE(FEATURE_DATA_SIZE,1), HID_JOYSTICK_REPORT_ID };
volatile HIDBuffer_t fbSwitch { featureBuffer, HID_BUFFER_SIZE(FEATURE_DATA_SIZE,1), 0 };
HIDJoystick Joystick2(HID, HID_JOYSTICK_REPORT_ID+1);

void beginUSBHID() {
  USBComposite.setProductString("Multiadapter Single Joystick");
  USBComposite.setVendorId(VENDOR_ID);
  USBComposite.setProductId(PRODUCT_ID_SINGLE);  
  HID.setTXInterval(4);
#ifdef SERIAL_DEBUG
  HID.begin(CompositeSerial,reportDescription,sizeof(reportDescription));
#else
  HID.begin(reportDescription,sizeof(reportDescription));
#endif
  HID.clearBuffers();
  HID.addFeatureBuffer(&fb);
  Joystick.setManualReportMode(true);
  for (int i=0;i<32;i++) Joystick.button(i+1,0);
  delay(500);
}

void endUSBHID() {
  HID.end();
}

void beginSwitch() {
  USBComposite.setProductString("Emulated Horipad");
  USBComposite.setVendorId(0x0F0D);
  USBComposite.setProductId(0x00c1);  
  HID.begin(switchReportDescription,sizeof(switchReportDescription));
  HID.clearBuffers();
  HID.addFeatureBuffer(&fbSwitch);
  Switch.setManualReportMode(true);
  Switch.buttons(0);
  Switch.dpad(HIDSwitchController::DPAD_NEUTRAL);
  delay(500);
}

void endSwitch() {
  Switch.end();
}

void beginDual() {
  USBComposite.setProductString("Multiadapter Dual Joystick");
  USBComposite.setVendorId(VENDOR_ID);
  USBComposite.setProductId(PRODUCT_ID_DUAL);  
#ifdef SERIAL_DEBUG
  HID.begin(CompositeSerial, dualJoystickReportDescription,sizeof(dualJoystickReportDescription));
#else
  HID.begin(dualJoystickReportDescription,sizeof(dualJoystickReportDescription));
//  USBHID.begin(reportDescription,sizeof(reportDescription));
#endif
  HID.addFeatureBuffer(&fb);
  Joystick.setManualReportMode(true);
  Joystick2.setManualReportMode(true);
  for (int i=0;i<32;i++) {
    Joystick.button(i+1,0);
    Joystick2.button(i+1,0);
  }
  delay(500);
}

void endDual() {
  HID.end();
}

void setup() {
#ifdef directionSwitch
  pinMode(directionSwitch, INPUT_PULLDOWN);
#endif
  USBComposite.setManufacturerString("Omega Centauri Software");
  for (int i=0; i<numIndicators; i++)
    pinMode(indicatorLEDs[i], OUTPUT);
  pinMode(downButton, INPUT_PULLDOWN);
  pinMode(upButton, INPUT_PULLDOWN);

  numDisplayableModes = 0;
  for (unsigned i=0; i<numInjectionModes; i++)
    if (injectors[i].show)
      numDisplayableModes++;
  
  DEBUG("gamecube controller adapter");

  exerciseMachineInit();

#ifdef ENABLE_GAMECUBE
  gc.begin();
#endif
#ifdef ENABLE_NUNCHUCK
  nunchuck.begin();
#endif

  debounceDown.begin();
  debounceUp.begin();

  pinMode(ledPinID, OUTPUT);

  EEPROM8_init();
  int i;
  if (debounceDown.getRawState() && debounceUp.getRawState())
    i = 0;
  else
    i = EEPROM8_getValue(EEPROM_VARIABLE_INJECTION_MODE);
  if (i < 0)
    injectionMode = 0;
  else
    injectionMode = i; 
  //injectionMode = 3; //wasd:DEBUG:TEST

  if (injectionMode >= numInjectionModes)
    injectionMode = 0;

  savedInjectionMode = injectionMode;

  currentUSBMode = injectors[injectionMode].usbMode;
  currentUSBMode->begin();
  
  updateDisplay();

  lastChangedModeTime = 0;
  iwdg_init(IWDG_PRE_256, watchdogSeconds*156);
}

//uint8_t poorManPWM = 0;
void updateLED(void) {
  if (((validDevices[0] != CONTROLLER_NONE) ^ exerciseMachineRotationDetector) && validUSB) {
        gpio_write_bit(ledPort, ledPin, 0); //poorManPWM);
    //poorManPWM ^= 1;
  }
  else {
    gpio_write_bit(ledPort, ledPin, 1);
    //analogWrite(ledPinID, 255);
  }
  //gpio_write_bit(ledPort, ledPin, ! (((validDevice != CONTROLLER_NONE) ^ exerciseMachineRotationDetector) && validUSB));
}

static uint16_t calibrate(uint16_t value, int16_t delta) {
  value += delta;
  if ((int16_t)value < 0)
    return 0;
  else if (value >= 1024) 
    return 1023;
  else
    return value; 
}

static uint16_t deadzone(uint16_t x) {
  if (x >= 512-DEADZONE_10BIT && x <= 512+DEADZONE_10BIT)
    return 512;
  else
    return x;
}

static uint8_t receiveReport(GameControllerData_t* data, uint8_t deviceNumber) {
  uint8_t success;
  uint8_t reservedDevice = deviceNumber > 0 ? validDevices[0] : CONTROLLER_NONE;
  uint8_t validDevice = validDevices[deviceNumber];
  bool rumble;

#ifdef ENABLE_GAMECUBE
  if (reservedDevice != CONTROLLER_GAMECUBE && ( validDevices[deviceNumber] == CONTROLLER_GAMECUBE || validDevice == CONTROLLER_NONE) ) {
    DEBUG("Trying gamecube");
    
    rumble = injectors[injectionMode].rumble && (leftMotor || rightMotor);
    
    if (! rumble) {
      lastRumbleOff = millis();
    }
    else {
      uint32_t delta = millis() - lastRumbleOff;
      if (delta >= MAX_RUMBLE_TIME)
        rumble = false;
      else {
        // do a poor man's PWM to adjust rumble speed
        uint32_t dutyCycle = 35 + ((uint32_t)leftMotor+2*(uint32_t)rightMotor)*65/(255*3);
        rumble = (delta % 100) <= dutyCycle;
      }
    }

    gc.setDPadToJoystick(injectors[injectionMode].dpadToJoystick);
    success = gc.readWithRumble(data, rumble);
    if (success) {
#if DEADZONE_10BIT > 0
      data->joystickX = deadzone(data->joystickX);
      data->joystickY = deadzone(data->joystickY);
      data->cX = deadzone(data->cX);
      data->cY = deadzone(data->cY);
#endif      
      DEBUG("Success");
      validDevices[deviceNumber] = CONTROLLER_GAMECUBE;
#ifdef ENABLE_AUTO_CALIBRATE            
      static int16_t calStick1X = 0;
      static int16_t calStick1Y = 0;
      static int16_t calStick2X = 0;
      static int16_t calStick2Y = 0;
      if (needToCalibrate) {
        calStick1X = data->joystickX-512;
        calStick1Y = data->joystickY-512;
        calStick2X = data->cX-512;
        calStick2Y = data->cY-512;
        needToCalibrate = false;
      }
      else {
        data->joystickX = calibrate(data->joystickX, calStick1X);
        data->joystickY = calibrate(data->joystickY, calStick1Y);
        data->cX = calibrate(data->cX, calStick2X);
        data->cY = calibrate(data->cY, calStick2Y);
      }
#endif      
      return 1;
    } 
    validDevice = CONTROLLER_NONE;
  }
#endif
#ifdef ENABLE_NUNCHUCK
  if (reservedDevice != CONTROLLER_NUNCHUCK && ( validDevice == CONTROLLER_NUNCHUCK || nunchuck.begin())) {
    success = nunchuck.read(data);
#ifdef SERIAL_DEBUG
    CompositeSerial.println(success);
#endif            
    if (success) {
      data->joystickX = deadzone(data->joystickX);
      data->joystickY = deadzone(data->joystickY);
      validDevices[deviceNumber] = CONTROLLER_NUNCHUCK;
      return 1;
    }
  }
#endif
  validDevices[deviceNumber] = CONTROLLER_NONE;

  data->joystickX = 512;
  data->joystickY = 512;
  data->cX = 512;
  data->cY = 512;
  data->buttons = 0;
  data->shoulderLeft = 0;
  data->shoulderRight = 0;
  data->device = CONTROLLER_NONE;

  return 1;
}

void setFeature(const void* s) {
  strcpy((char*)featureReport, (const char*)s);
  if (isModeSwitch()) 
    Switch.setFeature(featureReport);
  else if (isModeJoystick())
    Joystick.setFeature(featureReport);
}

void intToString(char* buf, int a) {
  if (a==0) {
    *buf++ = '0'; 
  }
  else {
    if (a<0) {
      *buf++ = '-';
      a = -a;
    }
    int place = 1;
    while(place * 10 > place && a / place > 0) {
      place *= 10;
    }
    if (a/place == 0) 
      place /= 10;
    do {
      int d = a/place;
      *buf++ = '0' + d;
      a -= d*place;
      place /= 10;
    } while(place>0);
  }
  *buf = 0;
}

bool getFeature(uint8_t* f) {
  if (isModeSwitch()) {
    return Switch.getFeature(f);
  }
  else if (isModeJoystick()) {
    return Joystick.getFeature(f);
  }
  else {
    return false;
  }
}

void pollFeatureRequests() {
  if (getFeature(featureReport)) {
    if (0==strcmp((char*)featureReport, "id?")) {
      setFeature("id=GameCubeControllerAdapter");
    }
    else if (0==strcmp((char*)featureReport, "m?") || 0==strcmp((char*)featureReport, "M?")) {
      featureReport[1] = '=';
      strcpy((char*)featureReport+2,featureReport[0]=='m' ? injectors[injectionMode].commandName : injectors[injectionMode].description);
      setFeature(featureReport);
    }
    else if (0==strncmp((char*)featureReport, "m:", 2) || 0==strncmp((char*)featureReport, "M:", 2)) {
      for (unsigned i=0; i < numInjectionModes; i++) {
        if (0==strncmp((char*)featureReport+2, featureReport[0]=='m' ? injectors[i].commandName : injectors[i].description, FEATURE_DATA_SIZE-2)) {
          injectionMode = i;
          lastChangedModeTime = millis();
          updateDisplay();
          break;
        }
      }
    }
    else if (0==strcmp((char*)featureReport, "modes?")) {
      strcpy((char*)featureReport, "modes=");
      intToString((char*)featureReport+6, numInjectionModes);
      setFeature(featureReport);
    }
    else if ((featureReport[0] == 'm' || featureReport[0] == 'M') && isdigit(featureReport[1]) && featureReport[strlen((char*)featureReport)-1]=='?') {
      unsigned n = atoi((char*)featureReport+1);
      intToString((char*)featureReport+1, n);
      strcat((char*)featureReport, "=");
      if (n<numInjectionModes) {
        strcat((char*)featureReport, featureReport[0] == 'm' ? injectors[n].commandName : injectors[n].description);
      }
      setFeature(featureReport);
    }
    else {
      setFeature("");
    }
  }
}

void adjustMode(int delta) {
  do {
    if (delta < 0 && injectionMode == 0)
      injectionMode = numInjectionModes;
    injectionMode += delta;
    injectionMode %= numInjectionModes; 
  } while (! injectors[injectionMode].show);
  lastChangedModeTime = millis();
  leftMotor = 0;
  rightMotor = 0;
  updateDisplay();
}

uint32_t prevT = 0;

void loop() {
  GameControllerData_t data;
  GameControllerData_t data2;
  ExerciseMachineData_t exerciseMachine;
  bool dual = false;

  uint32_t t0 = millis();
  while (debounceDown.getRawState() && debounceUp.getRawState() && (millis()-t0)<5000)
      updateLED();
  
  iwdg_feed();

  if ((millis()-t0)>=5000) {
    displayNumber(0xF);
    injectionMode = 0;
    EEPROM8_reset();
    updateDisplay();
    savedInjectionMode = 0;
  }
  else {
//    t0 = millis();
//    do 
    {
      if (debounceDown.wasReleased()) {
        adjustMode(-1);
      }
      
      if (debounceUp.wasPressed()) {
        adjustMode(1);
        DEBUG("Changed to "+String(injectionMode));
      }
      updateLED();
    } 
    //while((millis()-t0) < BUTTON_MONITOR_TIME_MS);
  }

  pollFeatureRequests();

  exerciseMachineUpdate(&exerciseMachine);
      
  if (savedInjectionMode != injectionMode && (millis()-lastChangedModeTime) >= saveInjectionModeAfterMillis) {
    DEBUG("Need to store");
    EEPROM8_storeValue(EEPROM_VARIABLE_INJECTION_MODE, injectionMode);
    savedInjectionMode = injectionMode;
  }

#ifndef SERIAL_DEBUG
  if (!USBComposite.isReady()) {
    // we're disconnected; save power by not talking to controller
    validUSB = 0;
    updateLED();
    return;
  } // TODO: fix library so it doesn't send on a disconnected connection; currently, we're relying on the watchdog reset 
  else {
    validUSB = 1;
  }
    // if a disconnection happens at the wrong time
#else
  validUSB = 1;
#endif

  dual = (currentUSBMode == &modeDualJoystick && injectors[injectionMode].usbMode == &modeDualJoystick) ||
         (currentUSBMode == &modeDualX360 && injectors[injectionMode].usbMode == &modeDualX360);
  uint32_t t1 = millis();
  uint32_t d = t1-prevT;
  if (d < 5)
    delay(5-d);
  prevT = t1;
  receiveReport(&data,0);
  if (dual)
    dual = (bool)receiveReport(&data2,1);
  DEBUG("joystick = "+String(data.joystickX)+","+String(data.joystickY));  

  if (USBComposite.isReady()) {
    inject(&Joystick, x360_1, injectors + injectionMode, &data, &exerciseMachine);

    if (dual) {
       inject(&Joystick2, x360_2, injectors + injectionMode, &data2, &exerciseMachine);
    } 
  }
    
  updateLED();
}
