arpruss/gamecube-usb-adapter/(commit log)

2017-09-30 pwm leds to save batteries
2017-10-02 fancier box
    [adaptercase.scad]
2017-10-05 calibration mode
2017-10-06 use unencrypted nunchuck
    [adaptercase.scad]
2017-10-08 greater speed range
    [adaptercase.scad, socketholder.scad]
2017-10-11 more PWM power saving; fix nunchuck stuff
    [gamecube.h, gamecubecontroller.ino, remap.ino]
2017-10-12 use newer Wire library
2017-10-13 remove poor man PWM as it oscillates too much
    [gamecube.h, gamecubecontroller.ino]
2017-10-17 use new addMidiHID
    [adaptercase.scad]
2017-10-19 monitor elliptical via interrupt
2017-12-12 mode switchable from pywinusb
2018-01-08 fix x360/joy switch
2018-01-12 led speed display
2018-01-15 exit xbox message
    [adaptercase.scad]
2018-03-12 wrong file was deleted
    [gamecubecontroller.ino]
2018-08-15 vibration support in x360 mode
    [gamecubecontroller.h, gamecubecontroller.ino, rumble.py, x360.ino]
2020-04-18 fix bug switching into x360/joy
    [gamecubecontroller.ino, remap.ino]
2022-01-26 Switch can be switched via commandline
2022-02-03 allow dual use buttons
2023-01-01 powerpad half
